Ueberspannung/PD-PPS-Controller/DOC/script.md

# Script Control Languge

#### Table of contents
- [features](#features)  
- [files](#files)  
  - [PRS file](parse-file)
  - [ERR file](error-file)

- [commands](#commands)  
  - [SET](#SET)  
  - [WAIT](#WAIT)  
  - [LOOP](#LOOP)  
  - [JUMP](#JUMP)  
  - [LABEL](#LABEL)  
  - [COMMENT](#COMMENT)  
  - [emty line](#empty-line)
  - [LOG](#LOG)  
  - [DISP](#DISP)  
  - [INFO](#INFO)  
  - [PASS](#PASS)  
  - [FAIL](#FAIL)  
  - [CLEAR](#CLEAR)  
  - [LOAD](#LOAD)  
  - [SAVE](#SAVE)  
- [examples](#examples)
  - [program with errors](#with-errors)
    - [program file](#program-file-with-error)
    - [error file](#error-file-with-error)
    - [parse file](#parse-file-with-error)
  - [porgram execution](#porgram-execution)
    - [parse file](#parse-file-without-error)
    - [log file](#log-file)

## features

Version 5.4 supports script control (on HW with SD Card slots).
with this script control one can  
control  
* the output state  
* the voltage setpoint  
* the current setpoint  
evaluate  
* the current output voltage  
* the current output current  
* the start mode (automatic or manuel)  
trigger  
* log file entries
* user messages

the scripting language supports (un)conditional jumps, (nested) loops and 10 general purpose unsigned 8 bit integers.
these integers can be saved to and loaded from the eeprom / config file.

when in AUTO ON mode the last program selected will be executed automatically on system start  

## files  
program files need to end on  **.PRG**. Only DOS 8.3 filenames are allowed.  
currently the system operates in verbose mode. This means an **.PRS** file will be generated
An **.ERR** file will be generated anyway, On succes this file will stay empty

### parse file
Te parse file consists of five sections:  
1. command and parameter decoding  
  for every parse program line the physical line number, the number of the corresponding program data element, the command and the parameters will be logged. Program data element and line number will be different becaus comments and empty lines will not produce an programm data element  
1. label checking  
  every JUMP command will be matched to its associated label line
1. loop checking pass 1  
  every loop header will be matched against its dedicated loop footer
1. loop checking pass 2  
  it will be checked if there are any unmatched loop commands
1. message list  
  a list of all defined logging and user messages will be created

### error file
Any errors during the parsing process will be reported in this file  
It contains the program line and the error message

possible error messages are:  

* line to long  
  the program line exceeds the buffer lenth (max. 80 chars)  
* unknown command  
  the identifier found in first place is not part of the supported commands  
* invalid label char  
  only "0" ... "9", "@", "A" ..."Z", "_", "a" ... "z" are allowed  
* label to long  
  a label is limited to 5 characters.   
* delay to long >60s  
   same delays are limited to 60000 ms  
* invalid delay  
   0 ms is not a vaild delay  
* previous expression pending  
  incompete expression in SET or JUMP statement  
* variable previosly used  
  varible previously used in current SET statement   
* multiple operators selected  
  all operators are single character operators "<", "=", ">", "+", "-"  
* no variable selected  
  operator used without variable  
* immedeate assignement only  
  some variables such as "O" support only direct assignement "="  
* invalid parameter sequence  
  variable selected in JUMP or SET does not exist  
* multiple conditions not allowed  
  jump statement does not support logic with multiple expressions  
* invalid operator  
  Output values do not support "equals" condion only "less than" or "greater than" are llowed  
* no operator selected  
  ther wos no operator detected bewtween a numerical value and an variable  
* out of message memory  
  program memory or message memory full  
* unexpected extra data  
  unexpected parameters, CLEAR with message, LOAD or SAVE with data  
* flag used without index  
  when using one of the 10 flags the use of the index digit is essential  
* closing loop without opening loop  
  there are more loop footers than headers  
* label has been previoulsly defined  
  a label has bben defined more than once, labels have to be unique  
* referenced label is undefined   
  the label reference by jump has not been defined
* opening loop without closing loop  
  there are more loop headers than footers
* expected data  
  message command without message

## commands

Notation for commands:  
- {a|b|c} options field, one of "a", "b" or "c"
- [val] numerical value with sign and decimals '.'
- [int] integral number, including sign, '+' is optional
- [uint] positive integral number 
- <...> optional parmeter

commands do not need to start on the first position of a line. Any number of whitespaces is allowed

there has to be only one command per line

System variables:  
- U output voltage  
  setpoint in SET command, measured output voltage in JUMP command  
- I output current  
  setpoint in SET command, measured output currend in JUMP command  
- O output switch state  
  modify in SET command, evaluate in jUMP command  
- R Reset Flag  
  for evaluation (JUMP) only,  
  0: program start was performed manually  
  1: program start was performed automatically on system start  
- F0 ... F9  
  10 8-bit flags read / write in JUMP / SET  

### SET
```
SET <U{=|+|-}[val]<V>> <I{=|+|-}[val]<A>> <O={0|1}> <Fn{=|+|-}[uint]> [val]<ms>  
```
- set / incrent / decrement voltage or current  
- set output switch   
- set / icnrement / decrement general purpose flags  
- delay after command of [val] ms  

general purpose flags:  
- [Fn] Flag n=0...9 Wertebereich 0..255  

operators
- '=' set operator, only positive values without sign  
- '+' incremant operator, only positive values without sign  
- '-' decremnt operator, only positive values without sign  

There has to be specified at least one of {U|I|O|Fn} 

### WAIT
```
WAIT [uint]<ms>
```
- pause for [uint] ms

### LOOP
```
LOOP <[uint]>
```
- loop header  
  loop cmd with parameter specifying the number of reptitions  
- loop footer
  loop comd without parameter

loop footer and headers will automatically be matched  
loops can be nested without limit  
loops can be exited with JUMP

### JUMP
```
JUMP <{ {U|I}{<|>}{val}<{V|A}> | {R|Fn|O}{<|=|>}{uint} }> [:LABEL]  
```

1. parameter  
   a) one conditon form {U|I|O|R|Fn} results in conditional jump  
   conditions on O or R need to be compared to 0 or 1
   b) [:LABEL] unconditional JUMP to :LABEL
1. parameter target LABEL.

### LABEL
```
:LABEL
```
JUMP target any sequence of up to 5 characters form [0 ... 9, @, A ... Z, _, a ... z]

### COMMENT

```
# comment text
```
single line command, comments at the end of a line are not allowed
any character sequece is allowed for comment text

# emty line
if ther is just a line spacing required, there no need for the comment command
an empty (or filled with whitespaces) line will do
 
### LOG
```
LOG <Text>
```

instead of automated logging, within a script the log command should be preferred.
this enables the user to controll the log file entries individually, depending on the current requirements

the log command could be used to
- either write o note to the logfile (command with parameter)
- or write the current data to the log file (voltage and current setpoint, output voltage and current readings, system temperature)  

### DISP
### INFO
### PASS
### FAIL
```
DISP <Text>
INFO <Text>
PASS <Text>
FAIL <Text>
```
display some characters.
the length of the text which can be displayed depends on the hardware

- in Terminal mode up to 50 characters can be displayed
- on the mini only 14 charactes can be displayed 
- on versions with 4x20 display the limit will be 18 characters (TBD)

depending on the hardware the text will be displayed in different styles

| hw | DISP | INFO | PASS | FAIL |
|----|:----:|:----:|:----:|:----:|
|terminal|white, low intensity|white, high intensity|green, high intensity|red, high intensity, blinking|
|mini|grey|white|green|red|
|4x20|text icon|i - icon|check icon|x - icon|

### CLEAR
```
CLEAR
```
clears the user message

### LOAD
```
LOAD
```
read all 10 user flags from eeprom / config file

### SAVE
```
SAVE
```
wrtite all 10 user flags to eeprom / config file

## examples

### with errors

#### program file-with error
```javascript {.line-numbers}
# test of current consumption

#start at 3.3V, limit current to 2,2A
set O=1 U=3.3V I=2.2A 1500ms

log
log increasing voltage
# increase voltage loop
:raise
	SET U+0.1V 100ms
	log
# stop test if voltage exceeds 14V
jump u>14.0V :err1
# continue if current limit not yet reached
jump i<0.7A :raise

log
log lowering voltage to match Iout=200mA
# decrease voltage loop
:lower
	set U=-0.1V 100ms
	log
# stop test if voltage falls below 3.6V
jump U<3.6V :err2
# continue if lower current limit not yet reached
jump I>0.2A :lower

# succes: 700mA reached below 14V and 200mA reached above 3.6V
log setpoint succesfully reached
pass Test O.K.
set O=0 7500
jump stop

# error message at upper limit
:err1
fail I<700mA!
log fail at upper testpoint
set o=0 7500
jump :stop

# error message at lower limit
:er2
fail I>200mA!
log fail at lower testpoint
set o=0 7500

# end of program
:stop
clear
```

#### error file with error

this produces on error file:
```
 21: multiple operators selected
 32: invalid parameter sequence
 24: referenced label is undefined
 32: referenced label is undefined
```

in line 21:
```
	set U=-0.1V 100ms
```
assignment with sign is not allowed. this should be an decrement such as
```
	set U-0.1V 100ms
```

in line 32
```
jump stop
```
labels need to be started by an ":"
```
jump :stop
```

in line 24
```
jump U<3.6V :err2
```
the target should be line 42 but the label has been mistyped
```
:er2
```
#### parse file with error

The vebose output produces a parse file:

```
 ***********************************************
  2672: log file opened LIMIT.LOG
  2672: error file opened LIMIT.ERR
  2672: prarser file opened LIMIT.PRS
  2672: Start load file LIMIT.PRG
  2680: line #1 : parsing COMMENT: test of current consumption
  2711: line #2  - / - 
  2737: line #3 : parsing COMMENT:start at 3.3V, limit current to 2,2A
  2767: line #4 : parsing SET, PDE=0, U=3300mV, I=2200mA, O=ON, Delay= 1500ms
  2798: line #5  - / - 
  2823: line #6 : parsing LOG, PDE=1, MessageID= 255 ::::
  2850: line #7 : parsing LOG, PDE=2, MessageID= 0 ::increasing voltage::
  2874: line #8 : parsing COMMENT: increase voltage loop
  2906: line #9 : parsing LABEL, PDE=3, LabelID= 379AEE2A
  2929: line #10 : parsing SET, PDE=4, U=U+100mV, Delay= 100ms
  2959: line #11 : parsing LOG, PDE=5, MessageID= 255 ::::
  2984: line #12 : parsing COMMENT: stop test if voltage exceeds 14V
  3015: line #13 : parsing JUMP, PDE=6 JUMP on U > 14000 mV LabelID= AB7DC1
  3040: line #14 : parsing COMMENT: continue if current limit not yet reached
  3074: line #15 : parsing JUMP, PDE=7 JUMP on I < 700 mA LabelID= 379AEE2A
  3099: line #16  - / - 
  3128: line #17 : parsing LOG, PDE=8, MessageID= 255 ::::
  3151: line #18 : parsing LOG, PDE=9, MessageID= 1 ::lowering voltage to match Iout=200mA::
  3176: line #19 : parsing COMMENT: decrease voltage loop
  3207: line #20 : parsing LABEL, PDE=10, LabelID= 31D3CAB7
  3232: line #21 : parsing SET, PDE=11, U=100mV, Delay= 100ms
  3289: line #22 : parsing LOG, PDE=12, MessageID= 255 ::::
  3317: line #23 : parsing COMMENT: stop test if voltage falls below 3.6V
  3349: line #24 : parsing JUMP, PDE=13 JUMP on U < 3600 mV LabelID= AB7DC2
  3376: line #25 : parsing COMMENT: continue if lower current limit not yet reached
  3406: line #26 : parsing JUMP, PDE=14 JUMP on I > 200 mA LabelID= 31D3CAB7
  3430: line #27  - / - 
  3455: line #28 : parsing COMMENT: succes: 700mA reached below 14V and 200mA reached above 3.6V
  3486: line #29 : parsing LOG, PDE=15, MessageID= 2 ::setpoint succesfully reached::
  3515: line #30 : parsing disp, PDE=16, MessageType=PASS, MessageID= 3 Test O.K.
  3540: line #31 : parsing SET, PDE=17, O=OFF, Delay= 7500ms
  3571: line #32 : parsing JUMP, PDE=18 JUMP unconditional LabelID= 0
  3613: line #33  - / - 
  3638: line #34 : parsing COMMENT: error message at upper limit
  3668: line #35 : parsing LABEL, PDE=19, LabelID= AB7DC1
  3693: line #36 : parsing disp, PDE=20, MessageType=FAIL, MessageID= 4 I<700mA!
  3716: line #37 : parsing LOG, PDE=21, MessageID= 5 ::fail at upper testpoint::
  3743: line #38 : parsing SET, PDE=22, O=OFF, Delay= 7500ms
  3775: line #39 : parsing JUMP, PDE=23 JUMP unconditional LabelID= E39D35
  3800: line #40  - / - 
  3824: line #41 : parsing COMMENT: error message at lower limit
  3855: line #42 : parsing LABEL, PDE=24, LabelID= 2ADC2
  3879: line #43 : parsing disp, PDE=25, MessageType=FAIL, MessageID= 6 I>200mA!
  3902: line #44 : parsing LOG, PDE=26, MessageID= 7 ::fail at lower testpoint::
  3928: line #45 : parsing SET, PDE=27, O=OFF, Delay= 7500ms
  3962: line #46  - / - 
  3986: line #47 : parsing COMMENT: end of program
  4017: line #48 : parsing LABEL, PDE=28, LabelID= E39D35
  4164: line #49 : parsing disp, PDE=29, MessageType=CLEAR, MessageID= 255 
  4180: End load file, 49 lines processed, 30 PDEs created
***********************************************
  4180: checking labels 
  4181: label in line 9, PDE=3, label id=379AEE2A
  4182: JUMP in line 13, PDE=6, label id=AB7DC1, Target: PDE=19, line 35
  4187: JUMP in line 15, PDE=7, label id=379AEE2A, Target: PDE=3, line 9
  4188: label in line 20, PDE=10, label id=31D3CAB7
  4212: JUMP in line 24, PDE=13, label id=AB7DC2, Target: -/-
  4216: JUMP in line 26, PDE=14, label id=31D3CAB7, Target: PDE=10, line 20
  4240: JUMP in line 32, PDE=18, label id=0, Target: -/-
  4245: label in line 35, PDE=19, label id=AB7DC1
  4245: JUMP in line 39, PDE=23, label id=E39D35, Target: PDE=28, line 48
  4246: label in line 42, PDE=24, label id=2ADC2
  4250: label in line 48, PDE=28, label id=E39D35
  4251: End checking labels 
***********************************************
  4251: matching loops 
  4252: End matching loops 
***********************************************
  4252: checking loops 
  4252: End checking loops 
***********************************************
  4252: message List 
  4252: Message #0, length=18 ::increasing voltage::
  4254: Message #1, length=36 ::lowering voltage to match Iout=200mA::
  4254: Message #2, length=28 ::setpoint succesfully reached::
  4260: Message #3, length=9 ::Test O.K.::
  4261: Message #4, length=8 ::I<700mA!::
  4262: Message #5, length=23 ::fail at upper testpoint::
  4264: Message #6, length=8 ::I>200mA!::
  4265: Message #7, length=23 ::fail at lower testpoint::
  4265: End message list 
***********************************************
  4270: done close file
```

### porgram execution

#### parse file without error
when the errors in the program file above are corrected this parse output is generated

```
***********************************************
  2669: log file opened LIMIT.LOG
  2669: error file opened LIMIT.ERR
  2669: prarser file opened LIMIT.PRS
  2669: Start load file LIMIT.PRG
  2678: line #1 : parsing COMMENT: test of current consumption
  2708: line #2  - / - 
  2733: line #3 : parsing COMMENT:start at 3.3V, limit current to 2,2A
  2763: line #4 : parsing SET, PDE=0, U=3300mV, I=2200mA, O=ON, Delay= 1500ms
  2795: line #5  - / - 
  2819: line #6 : parsing LOG, PDE=1, MessageID= 255 ::::
  2846: line #7 : parsing LOG, PDE=2, MessageID= 0 ::increasing voltage::
  2869: line #8 : parsing COMMENT: increase voltage loop
  2901: line #9 : parsing LABEL, PDE=3, LabelID= 379AEE2A
  2925: line #10 : parsing SET, PDE=4, U=U+100mV, Delay= 100ms
  2956: line #11 : parsing LOG, PDE=5, MessageID= 255 ::::
  2981: line #12 : parsing COMMENT: stop test if voltage exceeds 14V
  3012: line #13 : parsing JUMP, PDE=6 JUMP on U > 14000 mV LabelID= AB7DC1
  3036: line #14 : parsing COMMENT: continue if current limit not yet reached
  3071: line #15 : parsing JUMP, PDE=7 JUMP on I < 700 mA LabelID= 379AEE2A
  3095: line #16  - / - 
  3118: line #17 : parsing LOG, PDE=8, MessageID= 255 ::::
  3143: line #18 : parsing LOG, PDE=9, MessageID= 1 ::lowering voltage to match Iout=200mA::
  3167: line #19 : parsing COMMENT: decrease voltage loop
  3198: line #20 : parsing LABEL, PDE=10, LabelID= 31D3CAB7
  3223: line #21 : parsing SET, PDE=11, U=U-100mV, Delay= 100ms
  3253: line #22 : parsing LOG, PDE=12, MessageID= 255 ::::
  3281: line #23 : parsing COMMENT: stop test if voltage falls below 3.6V
  3312: line #24 : parsing JUMP, PDE=13 JUMP on U < 3600 mV LabelID= AB7DC2
  3341: line #25 : parsing COMMENT: continue if lower current limit not yet reached
  3375: line #26 : parsing JUMP, PDE=14 JUMP on I > 200 mA LabelID= 31D3CAB7
  3399: line #27  - / - 
  3424: line #28 : parsing COMMENT: succes: 700mA reached below 14V and 200mA reached above 3.6V
  3455: line #29 : parsing LOG, PDE=15, MessageID= 2 ::setpoint succesfully reached::
  3484: line #30 : parsing disp, PDE=16, MessageType=PASS, MessageID= 3 Test O.K.
  3508: line #31 : parsing SET, PDE=17, O=OFF, Delay= 7500ms
  3539: line #32 : parsing JUMP, PDE=18 JUMP unconditional LabelID= E39D35
  3563: line #33  - / - 
  3587: line #34 : parsing COMMENT: error message at upper limit
  3618: line #35 : parsing LABEL, PDE=19, LabelID= AB7DC1
  3643: line #36 : parsing disp, PDE=20, MessageType=FAIL, MessageID= 4 I<700mA!
  3667: line #37 : parsing LOG, PDE=21, MessageID= 5 ::fail at upper testpoint::
  3695: line #38 : parsing SET, PDE=22, O=OFF, Delay= 7500ms
  3726: line #39 : parsing JUMP, PDE=23 JUMP unconditional LabelID= E39D35
  3749: line #40  - / - 
  3774: line #41 : parsing COMMENT: error message at lower limit
  3805: line #42 : parsing LABEL, PDE=24, LabelID= AB7DC2
  3830: line #43 : parsing disp, PDE=25, MessageType=FAIL, MessageID= 6 I>200mA!
  3853: line #44 : parsing LOG, PDE=26, MessageID= 7 ::fail at lower testpoint::
  3882: line #45 : parsing SET, PDE=27, O=OFF, Delay= 7500ms
  3912: line #46  - / - 
  3936: line #47 : parsing COMMENT: end of program
  3967: line #48 : parsing LABEL, PDE=28, LabelID= E39D35
  3991: line #49 : parsing disp, PDE=29, MessageType=CLEAR, MessageID= 255 
  4009: End load file, 49 lines processed, 30 PDEs created
***********************************************
  4009: checking labels 
  4010: label in line 9, PDE=3, label id=379AEE2A
  4010: JUMP in line 13, PDE=6, label id=AB7DC1, Target: PDE=19, line 35
  4015: JUMP in line 15, PDE=7, label id=379AEE2A, Target: PDE=3, line 9
  4016: label in line 20, PDE=10, label id=31D3CAB7
  4017: JUMP in line 24, PDE=13, label id=AB7DC2, Target: PDE=24, line 42
  4018: JUMP in line 26, PDE=14, label id=31D3CAB7, Target: PDE=10, line 20
  4019: JUMP in line 32, PDE=18, label id=E39D35, Target: PDE=28, line 48
  4021: label in line 35, PDE=19, label id=AB7DC1
  4021: JUMP in line 39, PDE=23, label id=E39D35, Target: PDE=28, line 48
  4022: label in line 42, PDE=24, label id=AB7DC2
  4027: label in line 48, PDE=28, label id=E39D35
  4027: End checking labels 
***********************************************
  4027: matching loops 
  4029: End matching loops 
***********************************************
  4029: checking loops 
  4029: End checking loops 
***********************************************
  4029: message List 
  4029: Message #0, length=18 ::increasing voltage::
  4030: Message #1, length=36 ::lowering voltage to match Iout=200mA::
  4034: Message #2, length=28 ::setpoint succesfully reached::
  4034: Message #3, length=9 ::Test O.K.::
  4035: Message #4, length=8 ::I<700mA!::
  4037: Message #5, length=23 ::fail at upper testpoint::
  4037: Message #6, length=8 ::I>200mA!::
  4039: Message #7, length=23 ::fail at lower testpoint::
  4039: End message list 
***********************************************
  4044: done close file
```

#### log file 
the program has been started three times with ~19 Ohms, ~8 Ohms and no load

```
****************************************************
* t;line;data    (t)ype: d=data, m=message, e=error
m;line;message
e;line;message
d;line;---- time -----;-U/V-;-I/A-;Uout/V;Iout/A;deg C
m;    ; 0  0:00:34.509;"program started"
d;   6; 0  0:00:36.048; 3.30; 2.20; 3.298; 0.176; 30.2;
m;   7; 0  0:00:36.064;"increasing voltage"
d;  11; 0  0:00:36.179; 3.40; 2.20; 3.396; 0.181; 30.2;
d;  11; 0  0:00:36.300; 3.50; 2.20; 3.495; 0.186; 30.2;
d;  11; 0  0:00:36.418; 3.60; 2.20; 3.590; 0.191; 30.2;
d;  11; 0  0:00:36.536; 3.70; 2.20; 3.681; 0.196; 30.2;
d;  11; 0  0:00:36.719; 3.80; 2.20; 3.778; 0.201; 30.2;
d;  11; 0  0:00:36.839; 3.90; 2.20; 3.897; 0.207; 30.2;
d;  11; 0  0:00:36.956; 4.00; 2.20; 3.993; 0.213; 30.2;
d;  11; 0  0:00:37.076; 4.10; 2.20; 4.092; 0.217; 30.2;
d;  11; 0  0:00:37.238; 4.20; 2.20; 4.186; 0.223; 30.2;
d;  11; 0  0:00:37.368; 4.30; 2.20; 4.300; 0.229; 30.2;
d;  11; 0  0:00:37.483; 4.40; 2.20; 4.399; 0.235; 30.2;
d;  11; 0  0:00:37.654; 4.50; 2.20; 4.499; 0.239; 30.2;
d;  11; 0  0:00:37.769; 4.60; 2.20; 4.594; 0.244; 30.2;
d;  11; 0  0:00:37.895; 4.70; 2.20; 4.688; 0.250; 30.2;
d;  11; 0  0:00:38.012; 4.80; 2.20; 4.787; 0.255; 30.2;
d;  11; 0  0:00:38.197; 4.90; 2.20; 4.882; 0.260; 30.2;
d;  11; 0  0:00:38.313; 5.00; 2.20; 5.014; 0.268; 30.2;
d;  11; 0  0:00:38.430; 5.10; 2.20; 5.104; 0.272; 30.2;
d;  11; 0  0:00:38.548; 5.20; 2.20; 5.193; 0.277; 30.2;
d;  11; 0  0:00:38.667; 5.30; 2.20; 5.291; 0.282; 30.2;
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
d;  11; 0  0:01:55.575; 7.10; 2.20; 7.092; 0.000; 30.1;
d;  11; 0  0:01:55.695; 7.20; 2.20; 7.183; 0.000; 30.1;
d;  11; 0  0:01:55.862; 7.30; 2.20; 7.304; 0.000; 30.1;
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
m;  37; 0  0:02:04.763;"fail at upper testpoint"
m;    ; 0  0:02:12.282;"program terminated"
```

[home](../README.md)
