Ueberspannung/PD-PPS-Controller/DOC/arm01-menu.md

## first ARM Menu
- [menue structure](#menue-structure)
- [menu modifications](#menu-modifications)
  - [new calibration menu](#new-calibration-menu)

### menu structure
the menu is organized similar to the [avr protoytpe](avr-menu.md) 
### menu modifications
#### new calibration menu
```
Current Calibration 
 internal   I.III A 
 reference  I.III A  
[i  i  i  x]     (i)
```
the current reading and the reference value have been reorganised.

[home](../README.md)
