Ueberspannung/PD-PPS-Controller/img/INA219-24C256.jpg

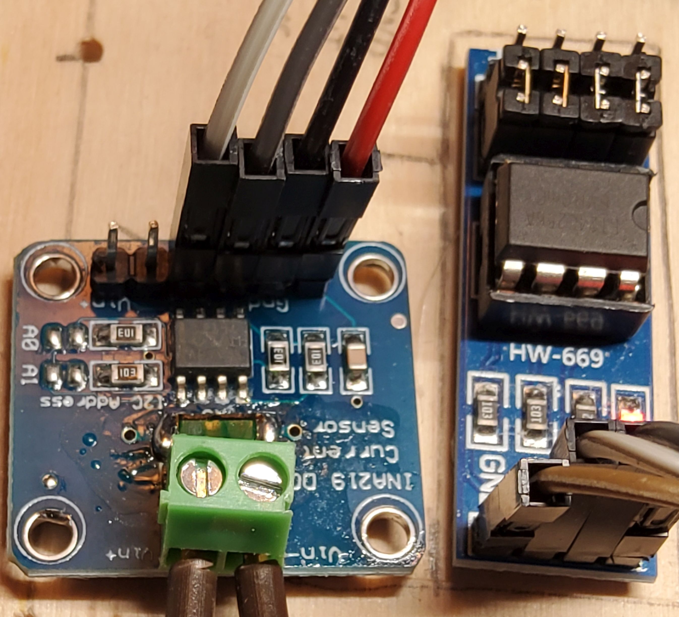
img/INA219-24C256.jpg
