Ueberspannung/PD-PPS-Controller/img/Menu-Cakibration.jpg

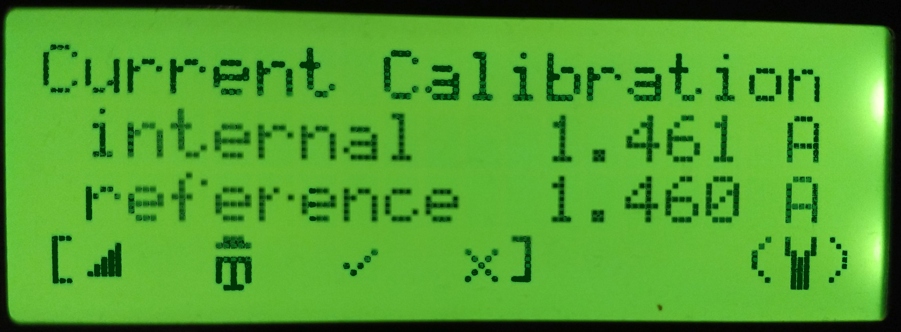
img/Menu-Cakibration.jpg
