Ueberspannung/PD-PPS-Controller/img/Menu-Main-3.3V-3A-Augmented-0.15A.jpg

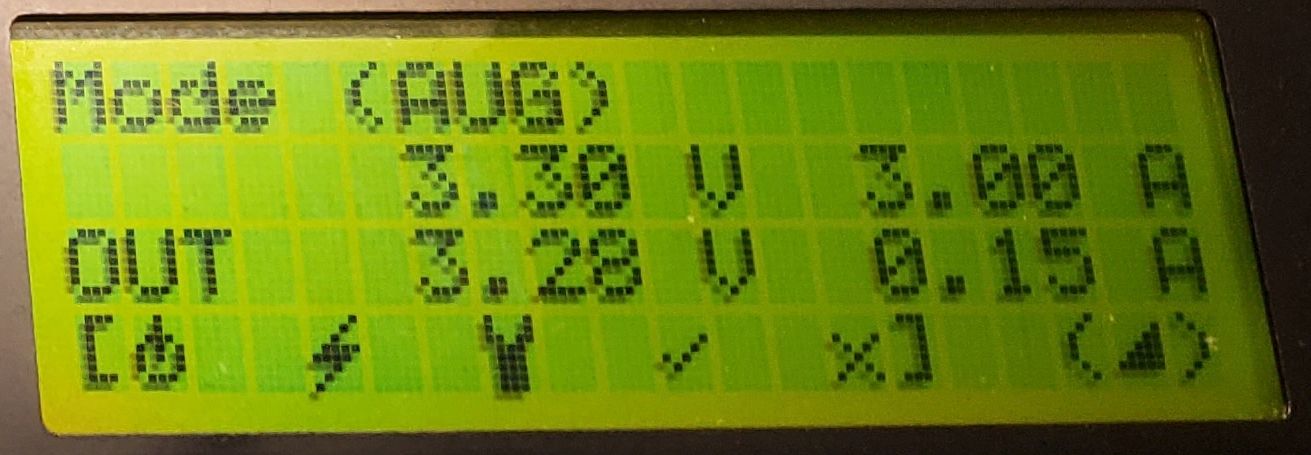
img/Menu-Main-3.3V-3A-Augmented-0.15A.jpg
