Ueberspannung/PD-PPS-Controller/img/Menu-Main-3.3V-3A-Augmented-0A.jpg

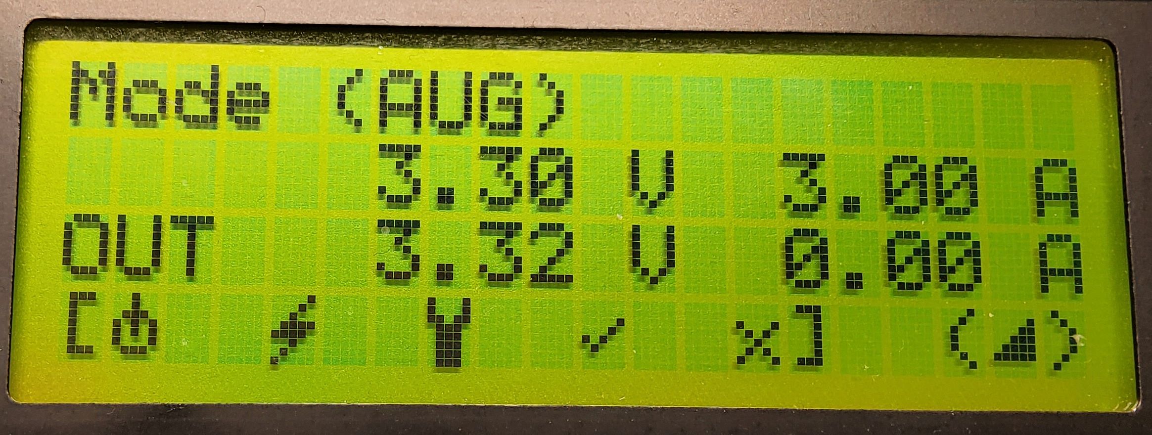
img/Menu-Main-3.3V-3A-Augmented-0A.jpg
