Ueberspannung/PD-PPS-Controller/img/Menu-Profile-3.3V-21V-Augmented.jpg

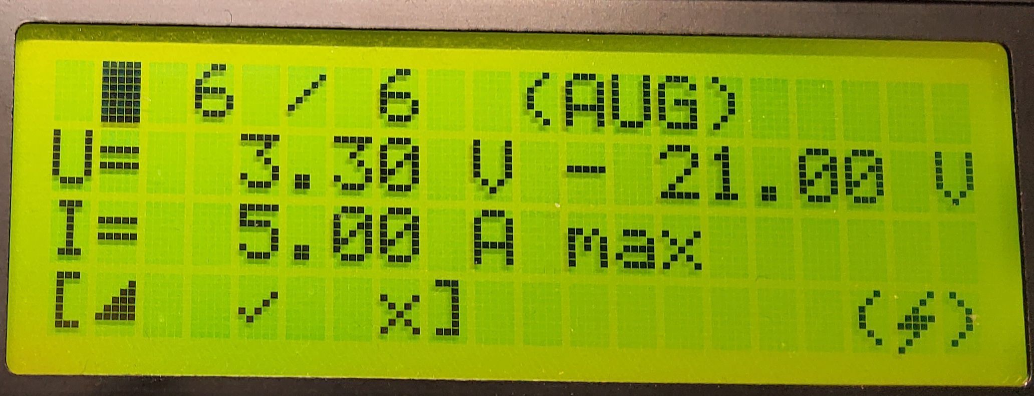
img/Menu-Profile-3.3V-21V-Augmented.jpg
