Ueberspannung/PD-PPS-Controller/img/Menu-Settings-Cal.jpg

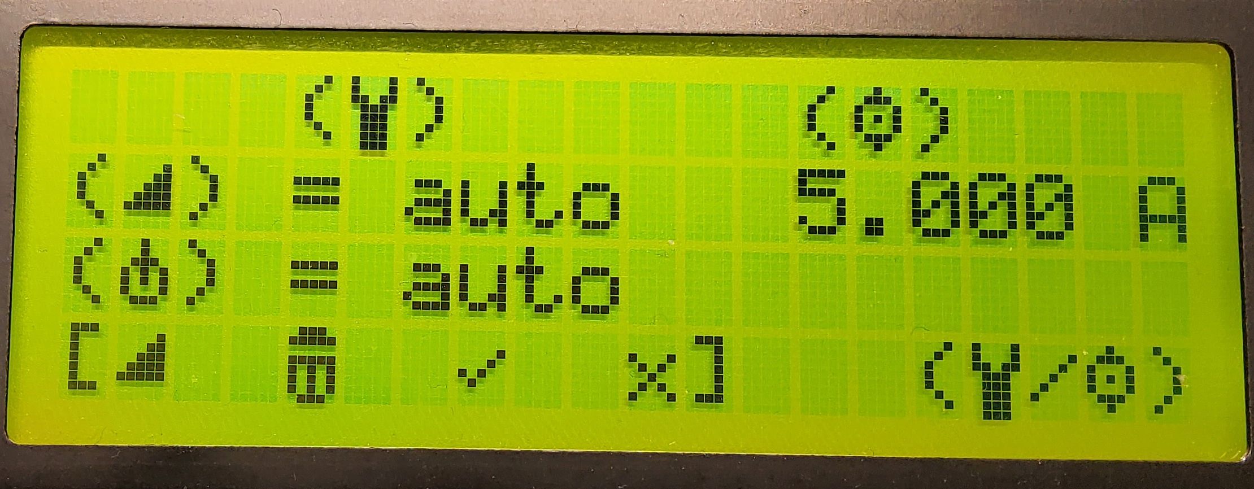
img/Menu-Settings-Cal.jpg
