Ueberspannung/PD-PPS-Controller/img/Menu-Settings.jpg

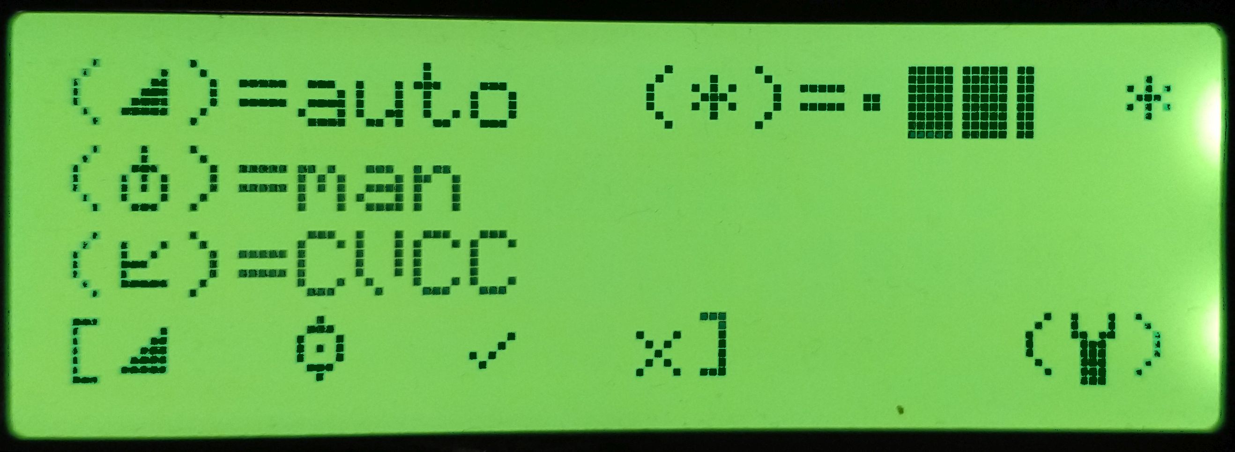
img/Menu-Settings.jpg
