Ueberspannung/PD-PPS-Controller/img/mini-menu-cc.png

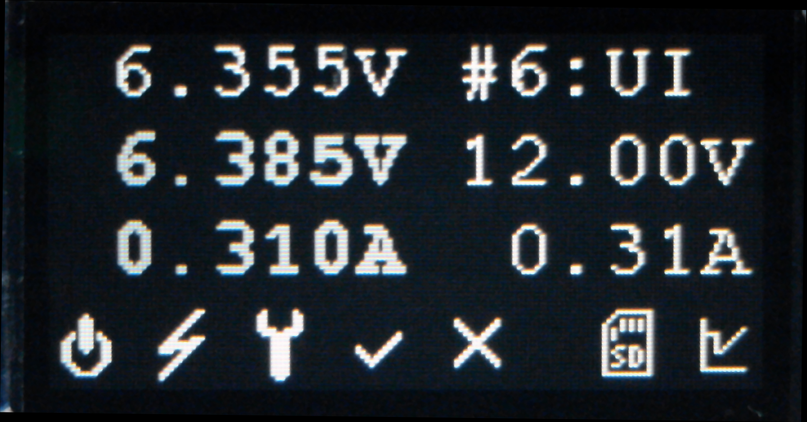
img/mini-menu-cc.png
