Ueberspannung/PD-PPS-Controller/img/mini-menu-profile-3.png

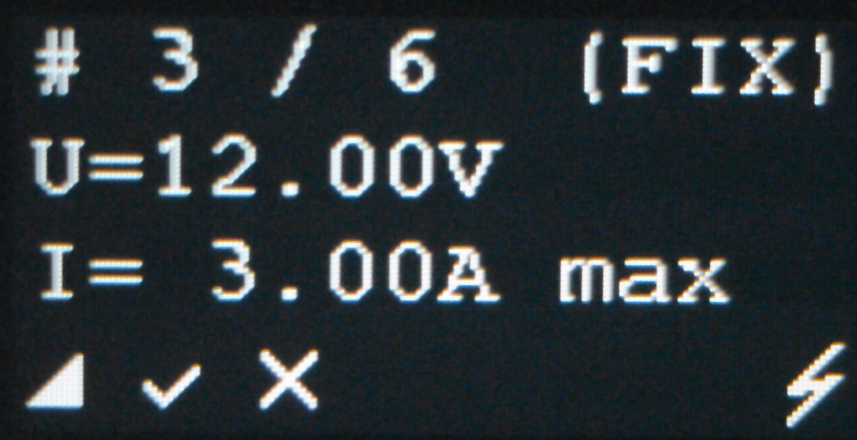
img/mini-menu-profile-3.png
