Ueberspannung/PD-PPS-Controller/img/mini-menu-settings-brightness.png

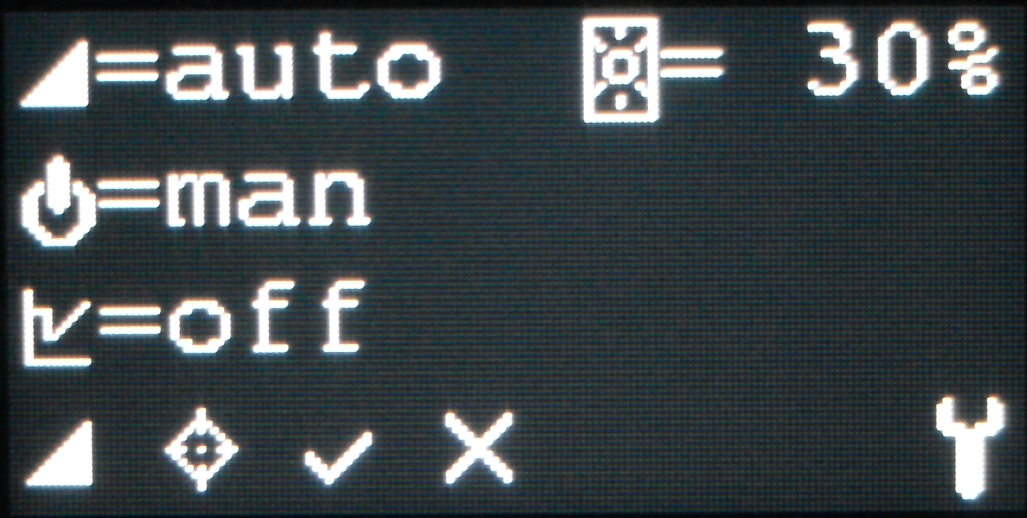
img/mini-menu-settings-brightness.png
