Ueberspannung/PD-PPS-Controller/img/mini-menu-settings-regulator.png

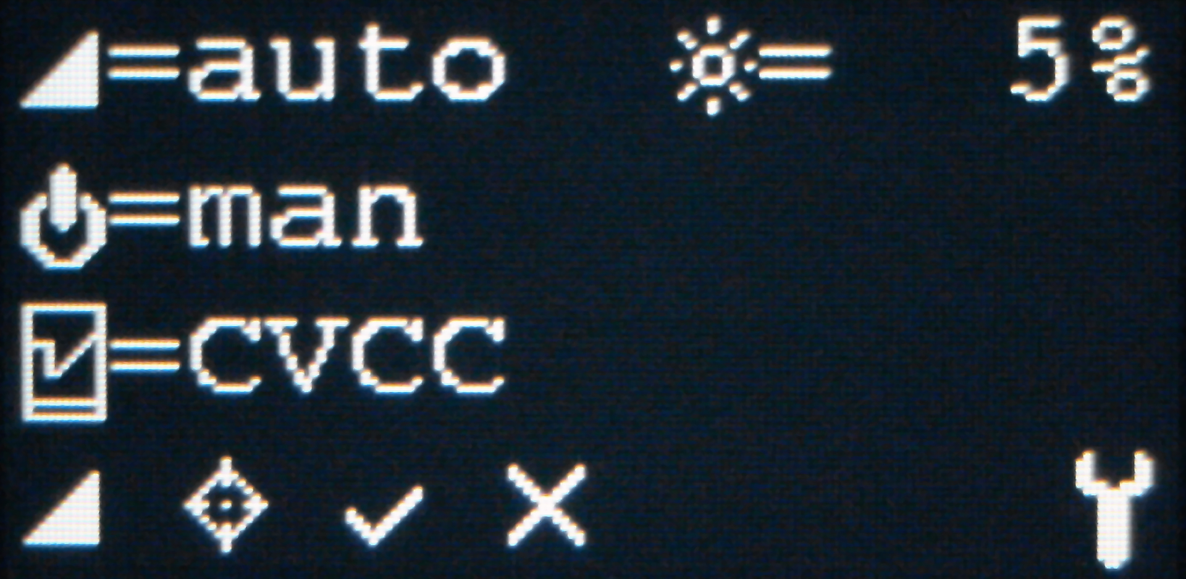
img/mini-menu-settings-regulator.png
