Ueberspannung/PD-PPS-Controller/img/mini_case_grey_ptsm_large.jpg

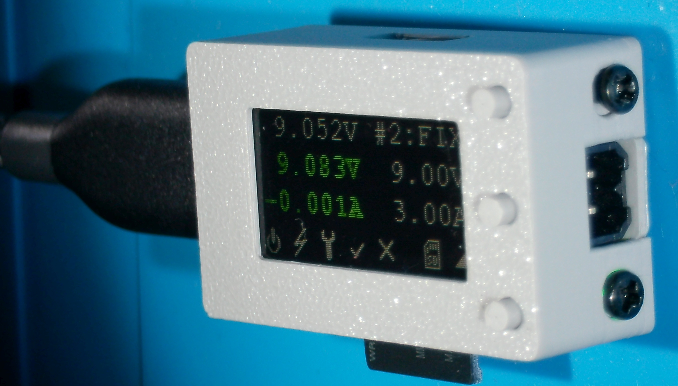
img/mini_case_grey_ptsm_large.jpg
