Ueberspannung/PD-PPS-Controller/img/USB-PD-4011A_02.jpg

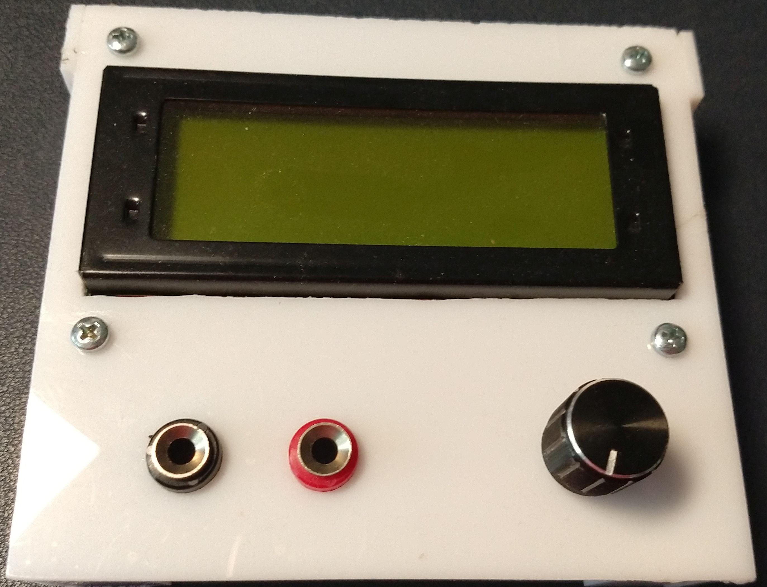
img/USB-PD-4011A_02.jpg
