Ueberspannung/PD-PPS-Controller/img/Menu-Main-12V-3A-Fix-0A.jpg

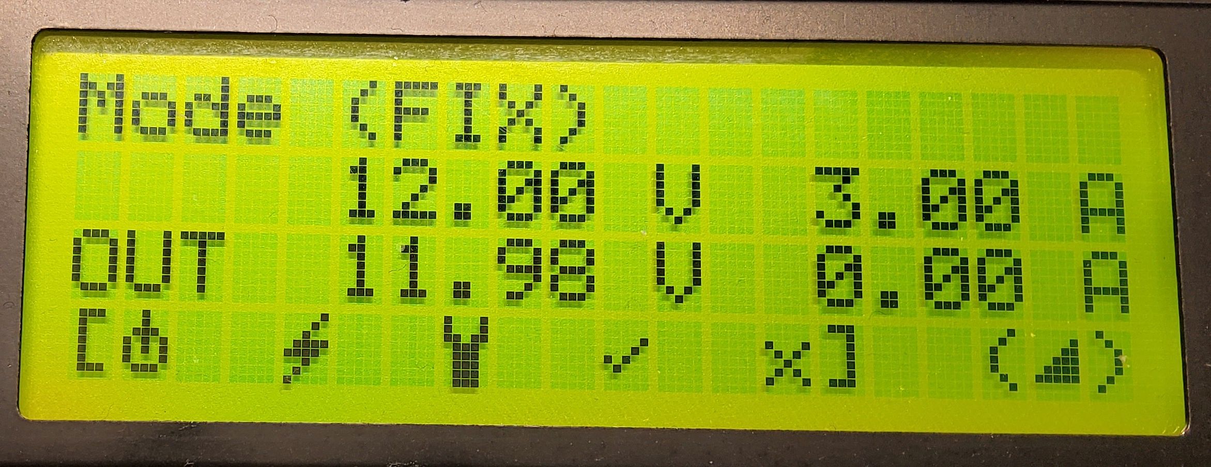
img/Menu-Main-12V-3A-Fix-0A.jpg
