Ueberspannung/PD-PPS-Controller/img/Menu-Profile-12V-Fix.jpg

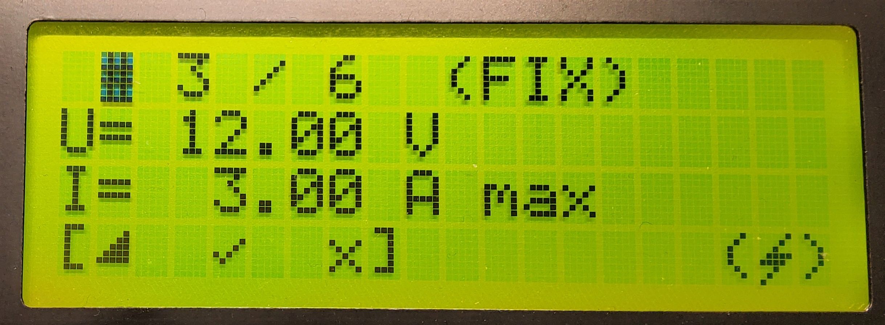
img/Menu-Profile-12V-Fix.jpg
