Ueberspannung/PD-PPS-Controller/img/mini-menu-main-12V-FIX-active-button.png

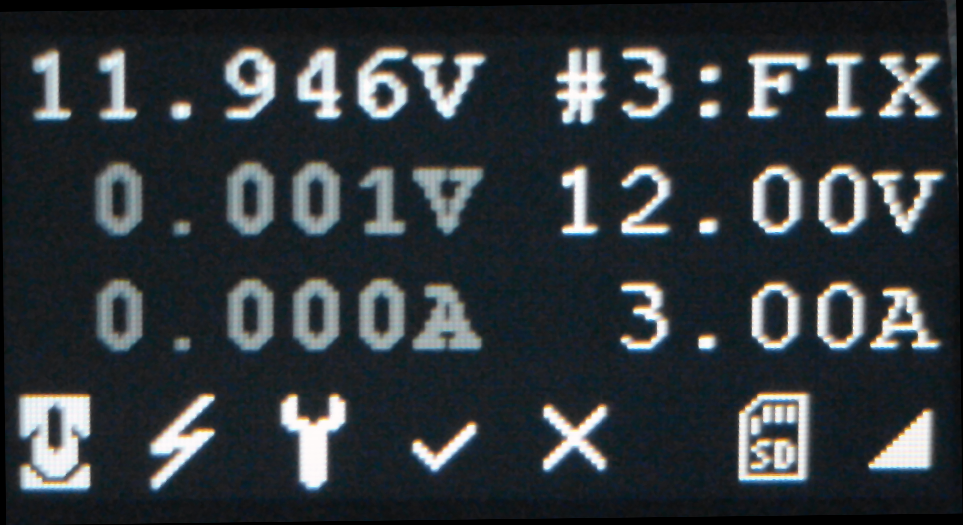
img/mini-menu-main-12V-FIX-active-button.png
