Ueberspannung/PD-PPS-Controller/SAM/hardware/first_arm/14011_0_USB-PD_Sch.pdf

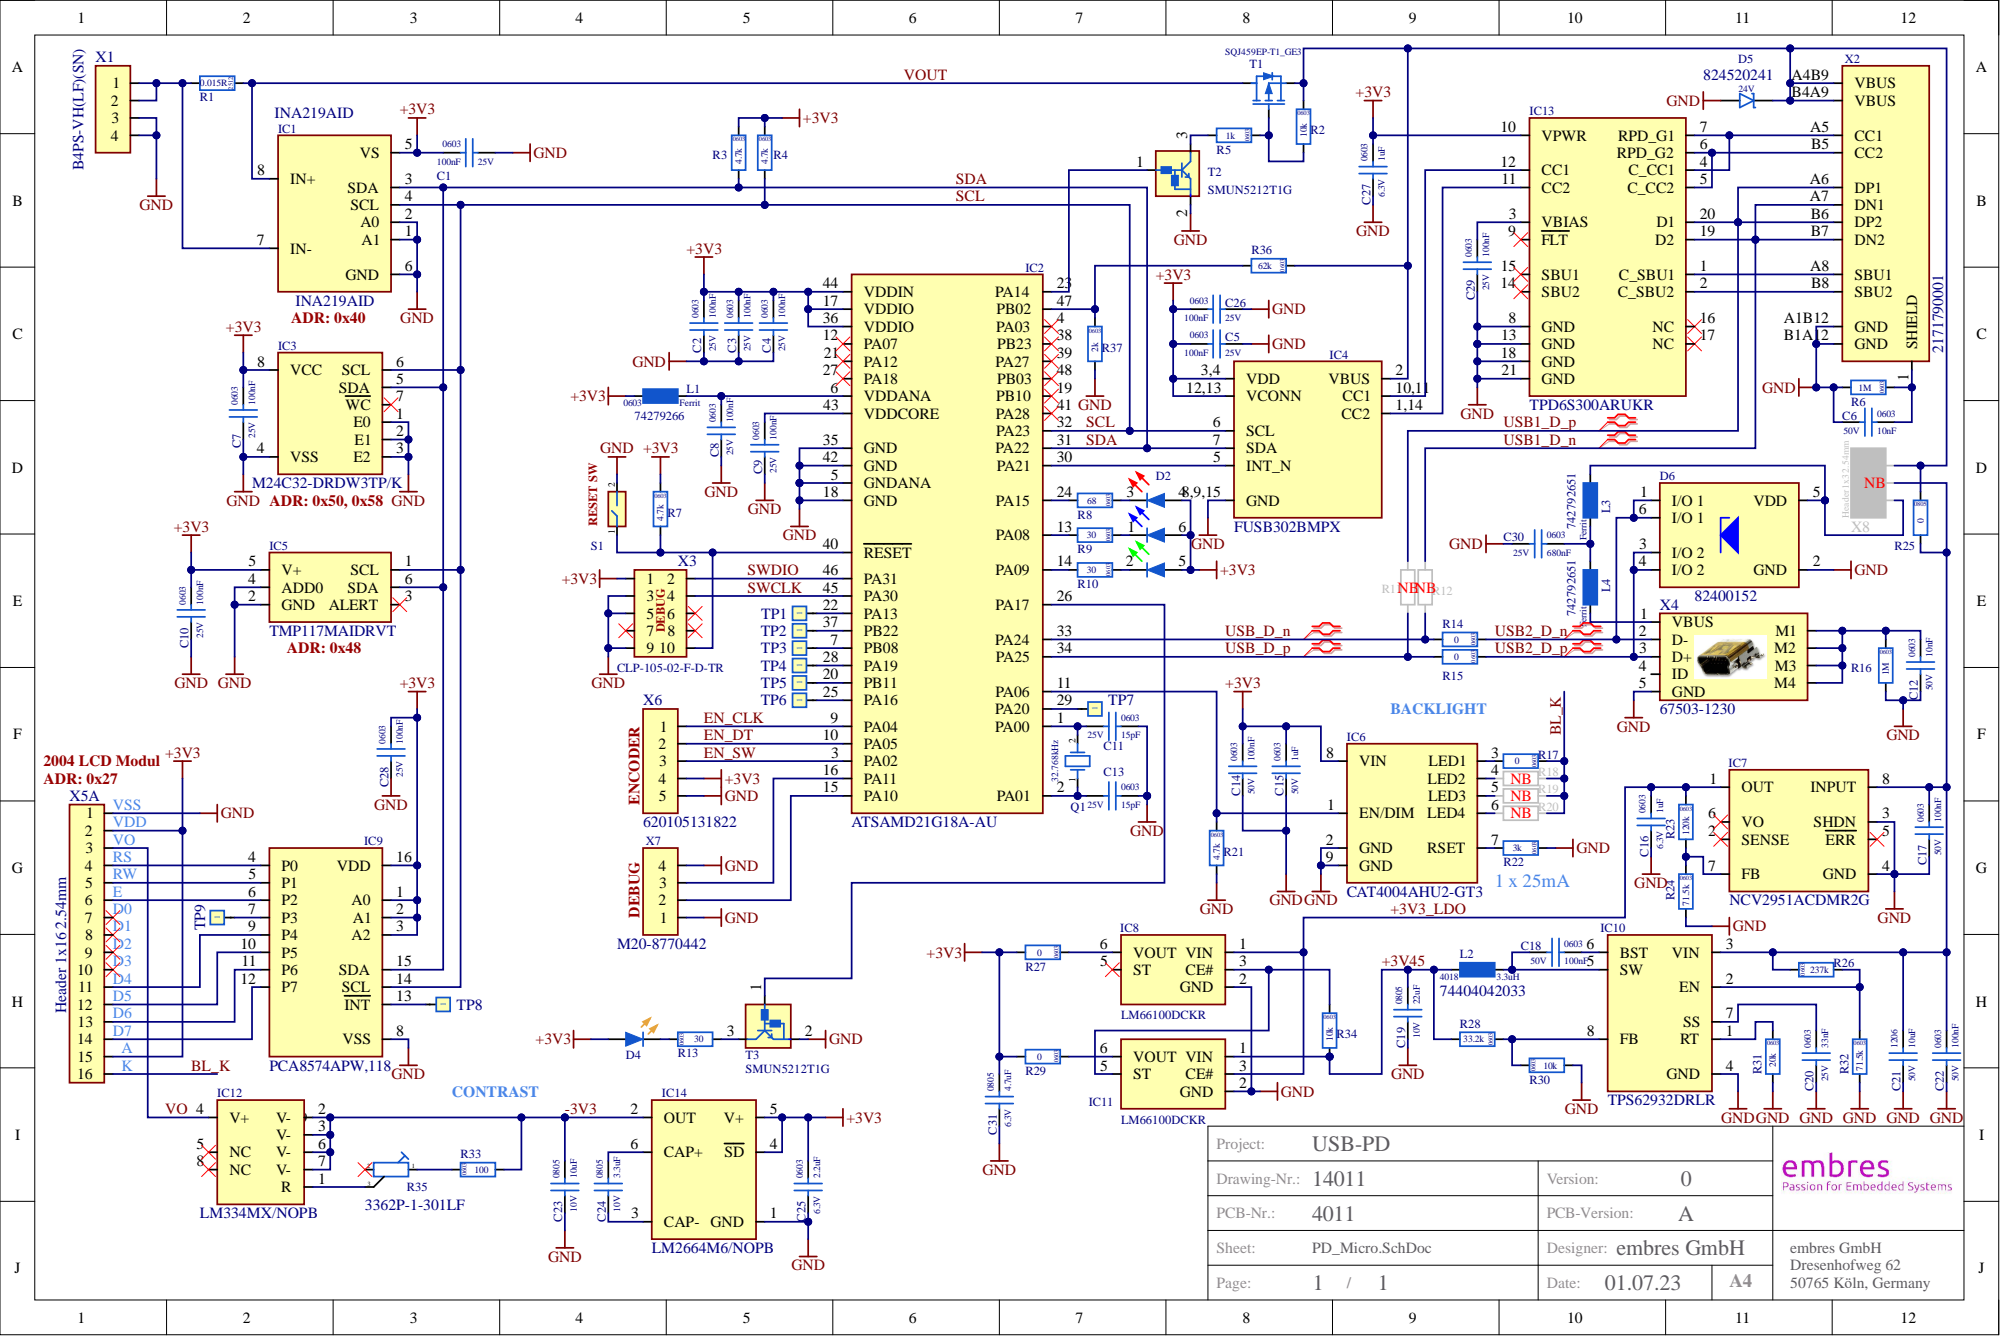
[picture p76: page 1]

I/O 1 1
I/O 1 6 I/O 2 3

Drawing-Nr.: 14011 | Version: 0

PCB-Nr.: 4011 Sheet: PD_Micro.SchDoc | A PCB-Version: Designer: embres GmbH
