Ueberspannung/PD-PPS-Controller/SAM/hardware/mini/14021_default_pdmicroMini_Sch.pdf

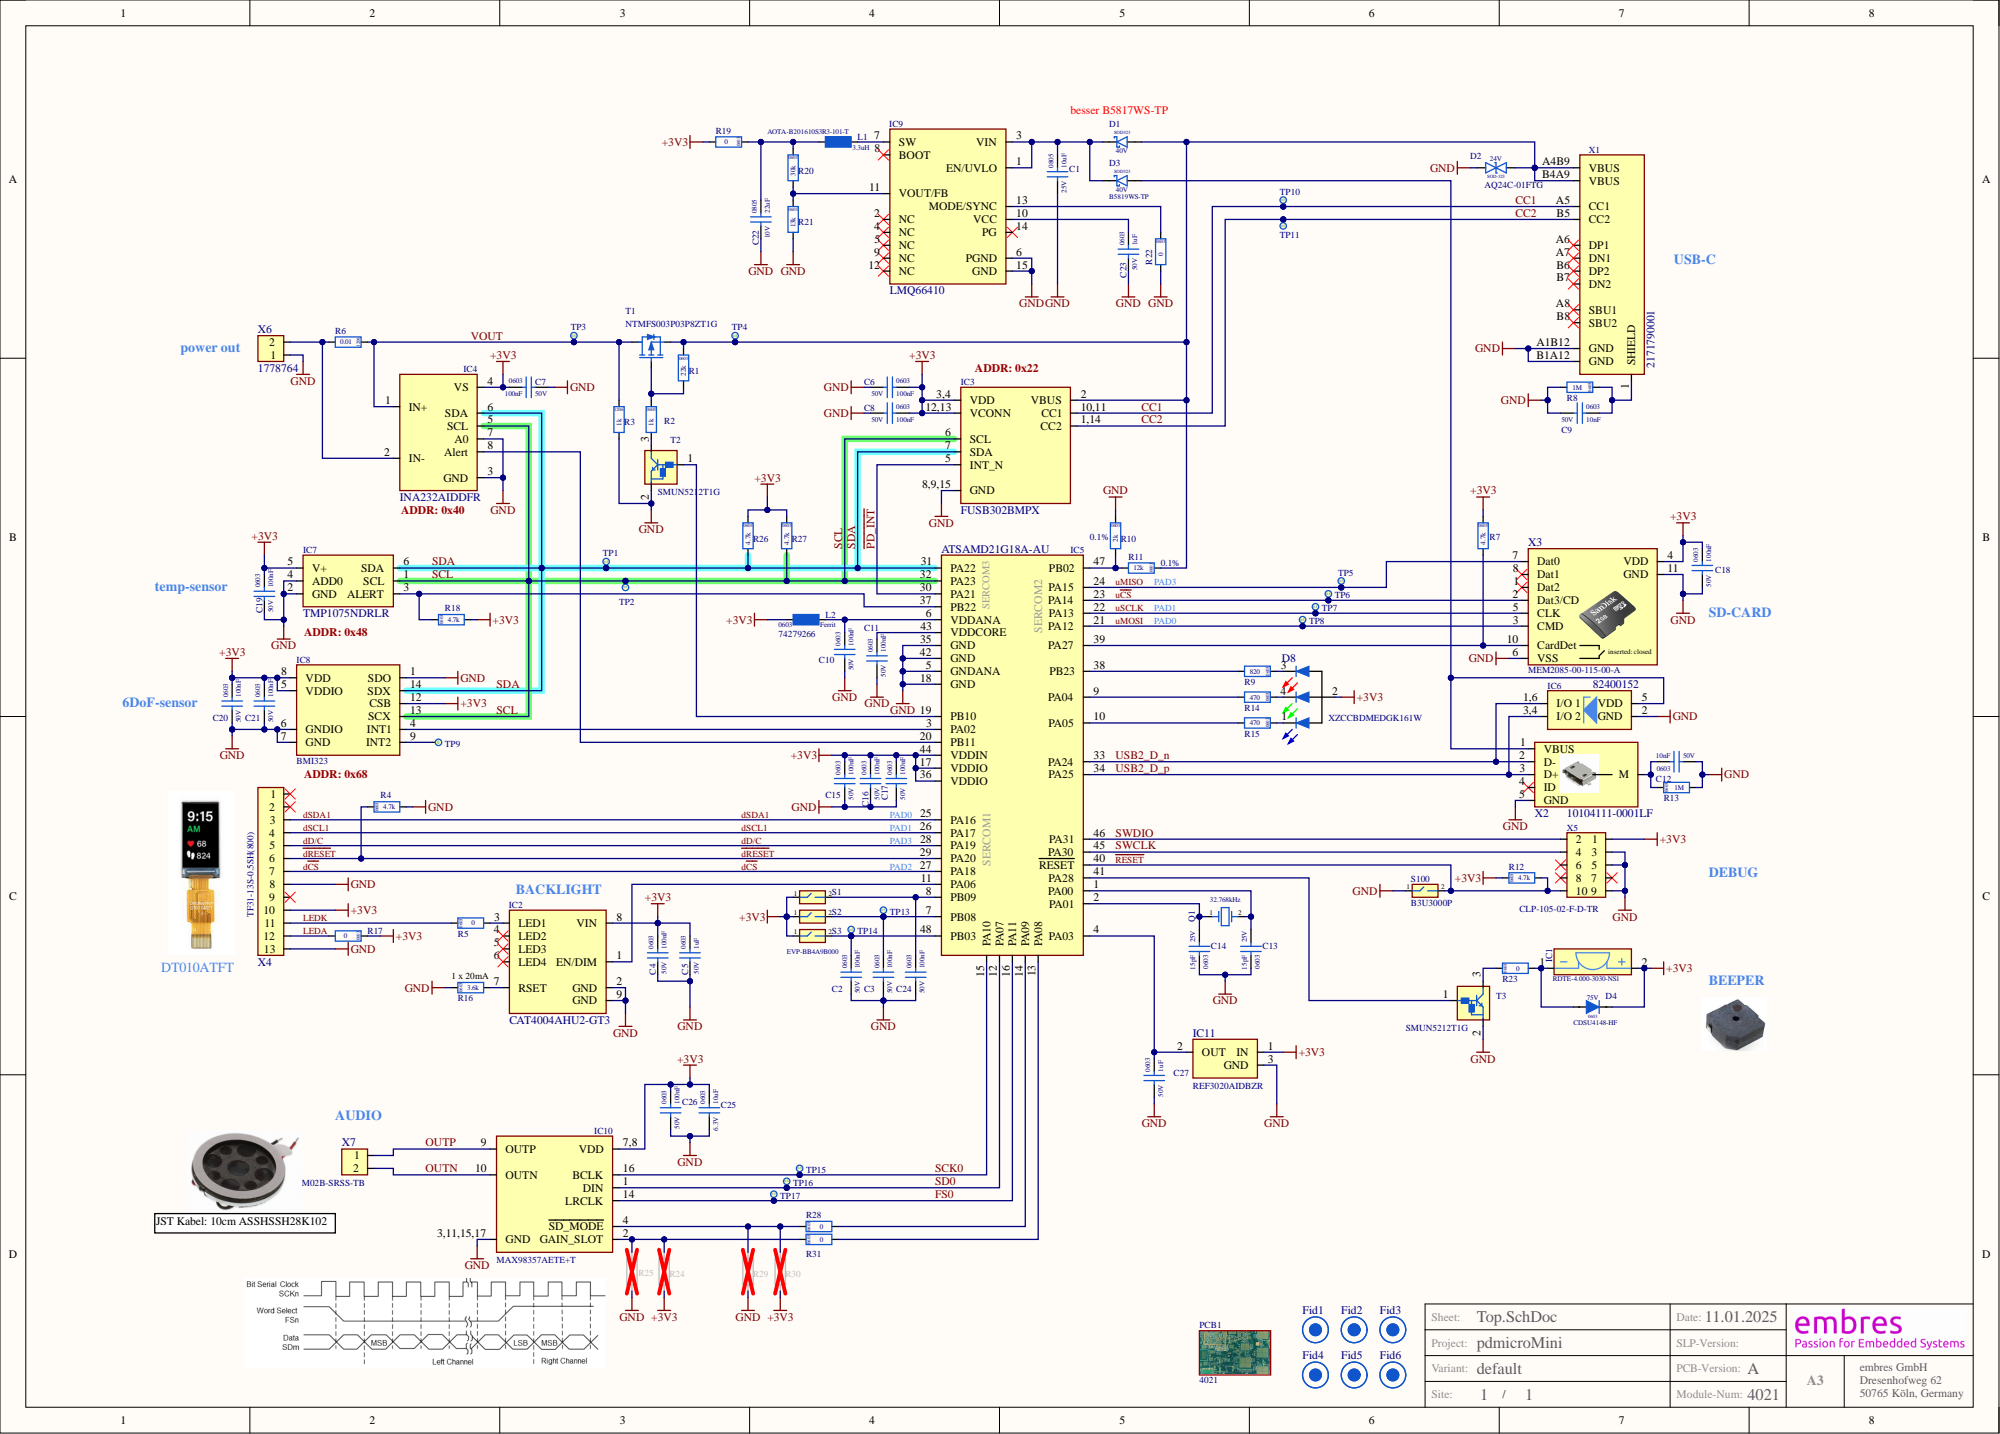
[picture p77: page 1]

0.5
TP2 | VDDIN 44 PA16 25 PA17 26 PA19 28 PA20 29 PA18 27 PA06 11

SDA
