Ueberspannung/PD-PPS-Controller/unifiedSW/USB-PD/src/modules/parameter.h

#ifndef _parameter_h_
#define _parameter_h_
#include <Arduino.h>
#include <stdint.h>
#include <stdbool.h>
#include "../memory/eeprom.h"
#include "controller.h"
#include "log.h"

class parameter
{
	public:

		parameter();

		bool process(void);		// returns true if busy
		uint8_t getProgress(void);
		void read(void);
		void write(void);
		void clear(bool bSetInitData);

		void setBrightness(uint8_t brightness);
		void setAutoSet(bool bAuto);
		void setAutoOn(bool bAuto);
		void setModePPS(bool bPPS);
		void setCVCC(controller_c::operating_mode_et mode);
		void setCalU(uint16_t Cal, uint16_t Ref);
		void setCalI(uint16_t Cal, uint16_t Ref);
		void setVoltage_mV(uint16_t VoltageStep);
		void setCurrent_mA(uint16_t CurrentStep);
		void setLogInteval(log_c::logInterval_et interval);
		void setExtendedMenu(bool bExtended);
		void setProgramName(const char * pName);
		void setFlags(const uint8_t *pFlags);

		uint8_t getBrightness(void);
		bool getAutoSet(void);
		bool getAutoOn(void);
		bool getModePPS(void);
		controller_c::operating_mode_et getCVCC(void);
		void getCalU(uint16_t *pCal, uint16_t *pRef);
		void getCalI(uint16_t *pCal, uint16_t *pRef);
		uint16_t getVoltage_mV(void);
		uint16_t getCurrent_mA(void);
		log_c::logInterval_et getLogInterval(void);
		bool getExtendedMenu(void);
		void getProgramName(char * pName);
		const char * getProgramName(void);
		void getFlags(uint8_t *pFlags);

		bool hasSD(void);

        bool isBusy(void) {return (paramState!=para_idle);}
	private:

		const uint16_t flagVal		=0xABBA;	// used flags: 0x1602, 0xAFFE
		const uint16_t flagAddress	=0x0000;
		const uint16_t DataOffset	=sizeof(uint16_t);
		const eeprom::eeprom_density_t EepromDesity=HWCFG_EEPROM_DENSITY;
		const uint8_t EepromAddress	=HWCFG_EEPROM_I2C_ADDR;

		static const uint8_t PROGMEM pgmFF[];

		static const char 		configFileName[];
		static const char 		configIDList[];
		static const uint8_t	configBufferSize=64;
		
		static const uint8_t	ProgramNameLenght=8;
		static const uint8_t	FlagNumber=10;
		
		typedef struct parameter_s
						{ 	uint16_t 	CalU;		// Calibration for Output Voltage
							uint16_t	RefU;		// internal measurement for Calibration
							uint16_t 	CalI;		// Calibration for output current
							uint16_t	RefI;		// internal measurement for calibration
							uint16_t	setU;		// start value voltage
							uint16_t	setI;		// start value current
							uint8_t		Brightness; // Brighness of display
							char		ProgramName[ProgramNameLenght+1];
							uint8_t		Flags[FlagNumber];
							uint8_t		PPS		:1;	// slect fix or pps profile
							uint8_t		autoSet	:1;	// Flag for automatic setup to last settings on startup
							uint8_t		autoOn	:1;	// implies autoSet but switches output on startup
							uint8_t		CVCC	:2;	// Flag for active Constant Voltage / Current Regulator
													// needs support for PPS
							uint8_t		Menu	:1;	// selects standard / extended menu
							uint8_t		Logging :4;	// Logging Mode 0-9 (off-30s)
							uint8_t		dir		:1;	// indicator for rotation memory usage
						} parameter_st;



		typedef enum:uint8_t {	para_start,
								para_init,
								para_clear,
								para_write_flag,
								para_write_first,
								para_write,
								para_read,
								para_idle,
								} para_stat_et;


		typedef enum:uint8_t { 	ITEM_CAL_U = 0,
								ITEM_REF_U,
								ITEM_CAL_I,
								ITEM_REF_I,
								ITEM_SET_U,
								ITEM_SET_I,
								ITEM_BRIGHTNESS,
								ITEM_PROGRAM_NAME,
								ITEM_FLAGS,
								ITEM_PPS,
								ITEM_AUTO_SET,
								ITEM_AUTO_ON,
								ITEM_REGULATOR,
								ITEM_LOGGING,
								ITEM_MENU,
								ITEM_END } parameter_et;
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
