Ueberspannung/PD-PPS-Controller/(commit log)

2024-12-16 updated README.md added AVR SW added SAM schematics
2024-12-18 updated README.md added fuse settings
2025-06-15 arm menu doc
2025-07-12 Modified Serial Programming Interface, Bugfix PS fail not recognize, Bugfix 0% Brightness in settings
    [SerialIF.cpp, SerialIF.h, UI.cpp, controller.cpp, controller.h, menu_mini.cpp]
2025-07-12 Updated dcoumentation for SPIF and added clear case
2025-07-12 Added clear case images
2025-09-21 Added images for first ARM prtotype
